JonahLiu/LogeekMax10/art/qr6200.png

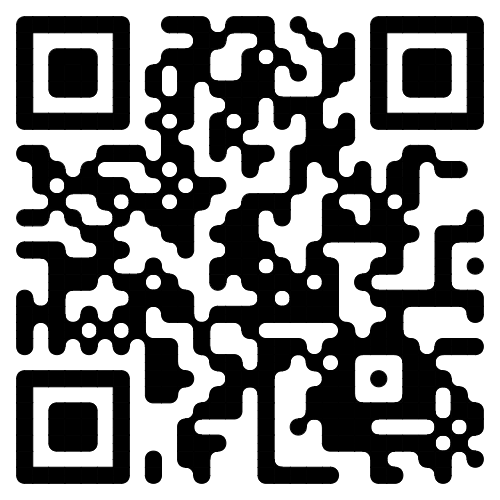
art/qr6200.png
