JonahLiu/LogeekMax10/doc/logeek_mk2.pdf

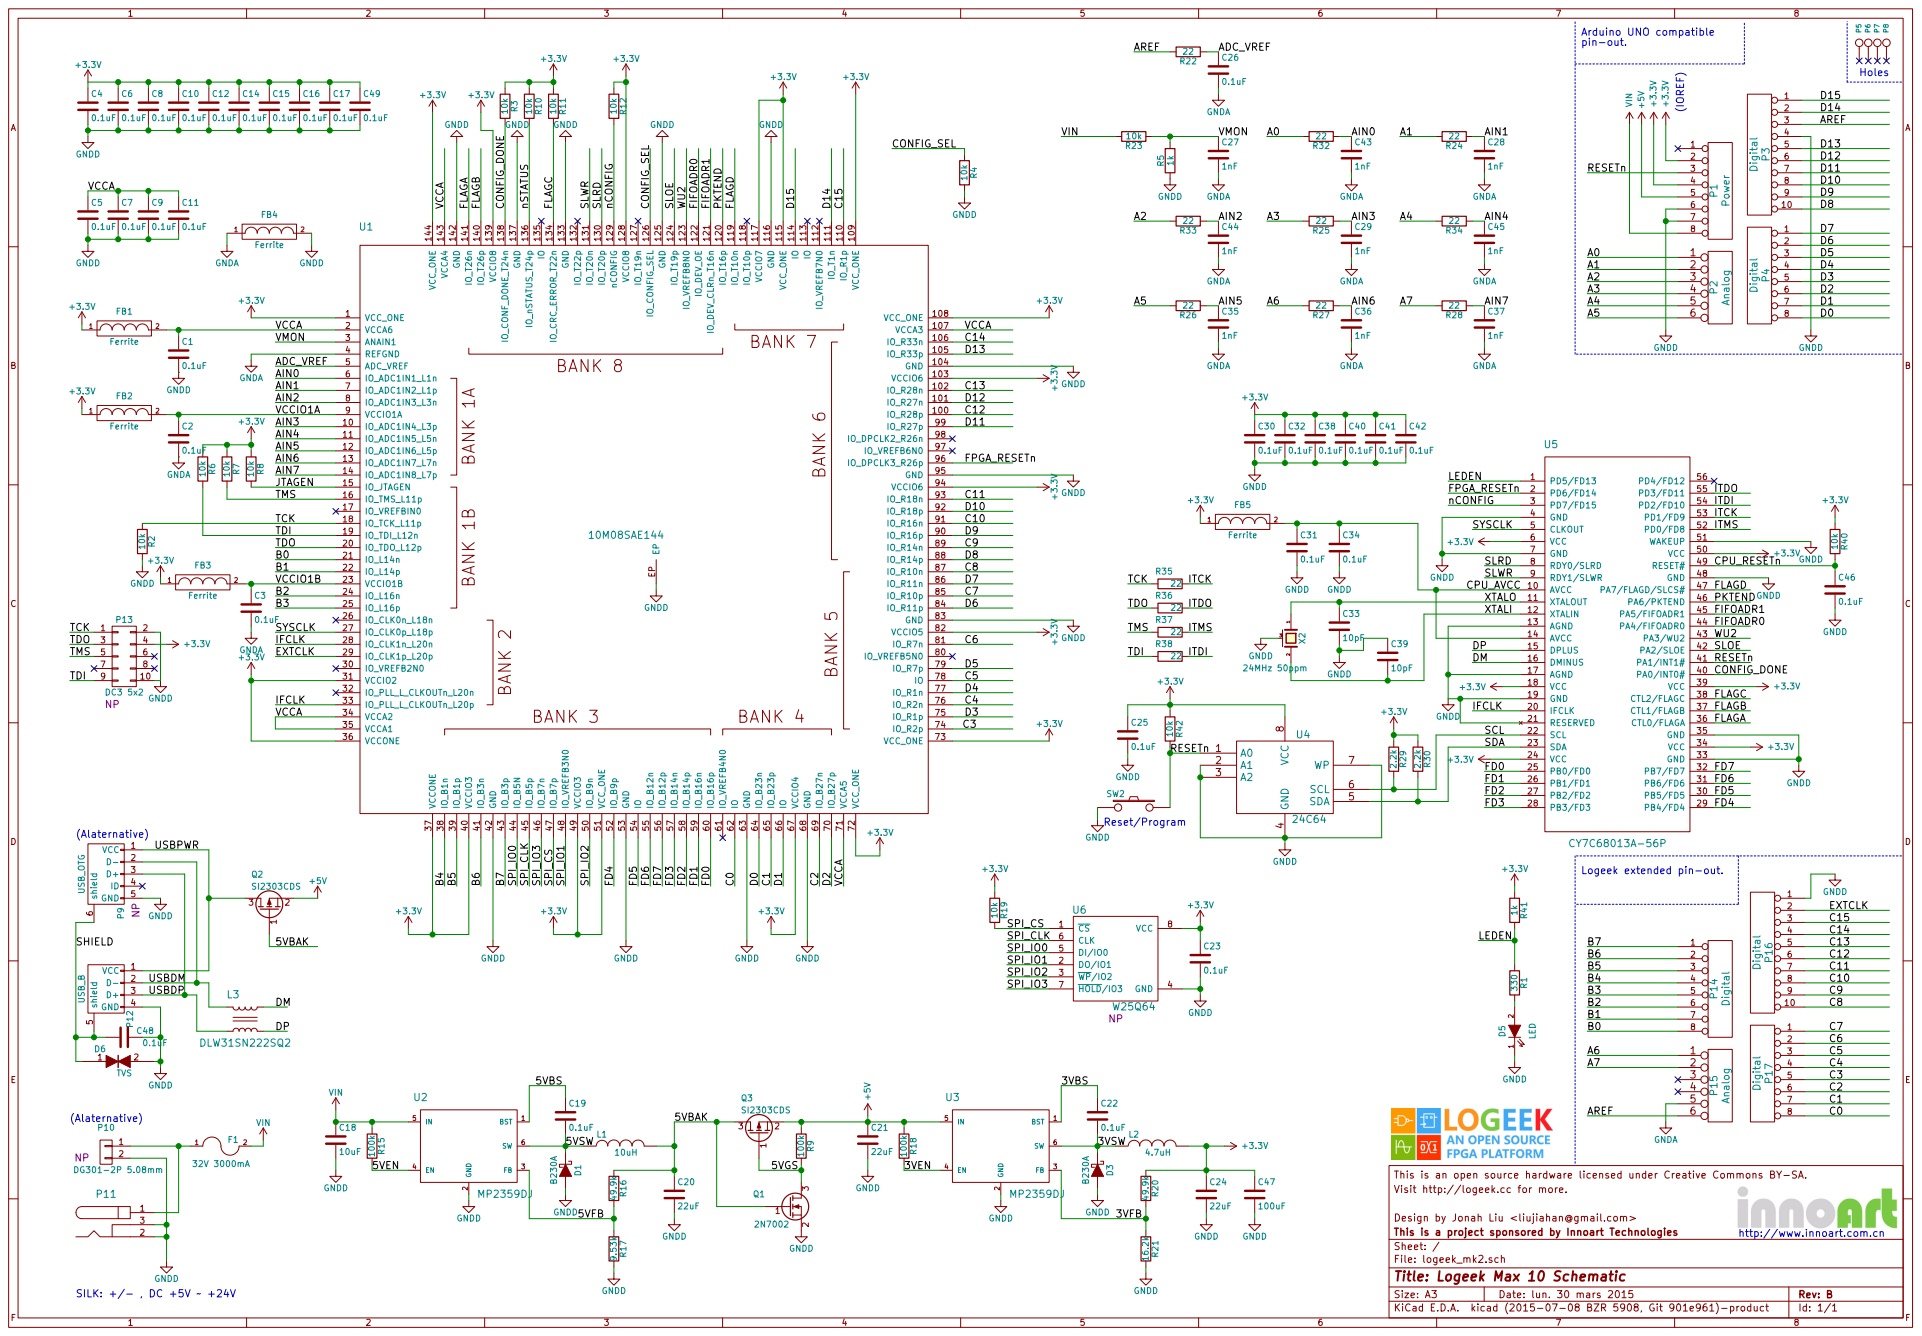
[picture p2: page 1]

This is an open source hardware licensed under Creative Commons BY-SA.
Visit http://logeek.cc for more.

Design by Jonah Liu <liujiahan@gmail.com>
File: logeek_mk2.sch Sheet: / This is a project sponsored by Innoart Technologies

http://www.innoart.com.cn

Id: 1/1 Title: Logeek Max 10 Schematic
