JonahLiu/LogeekMax10/doc/Refdes.pdf

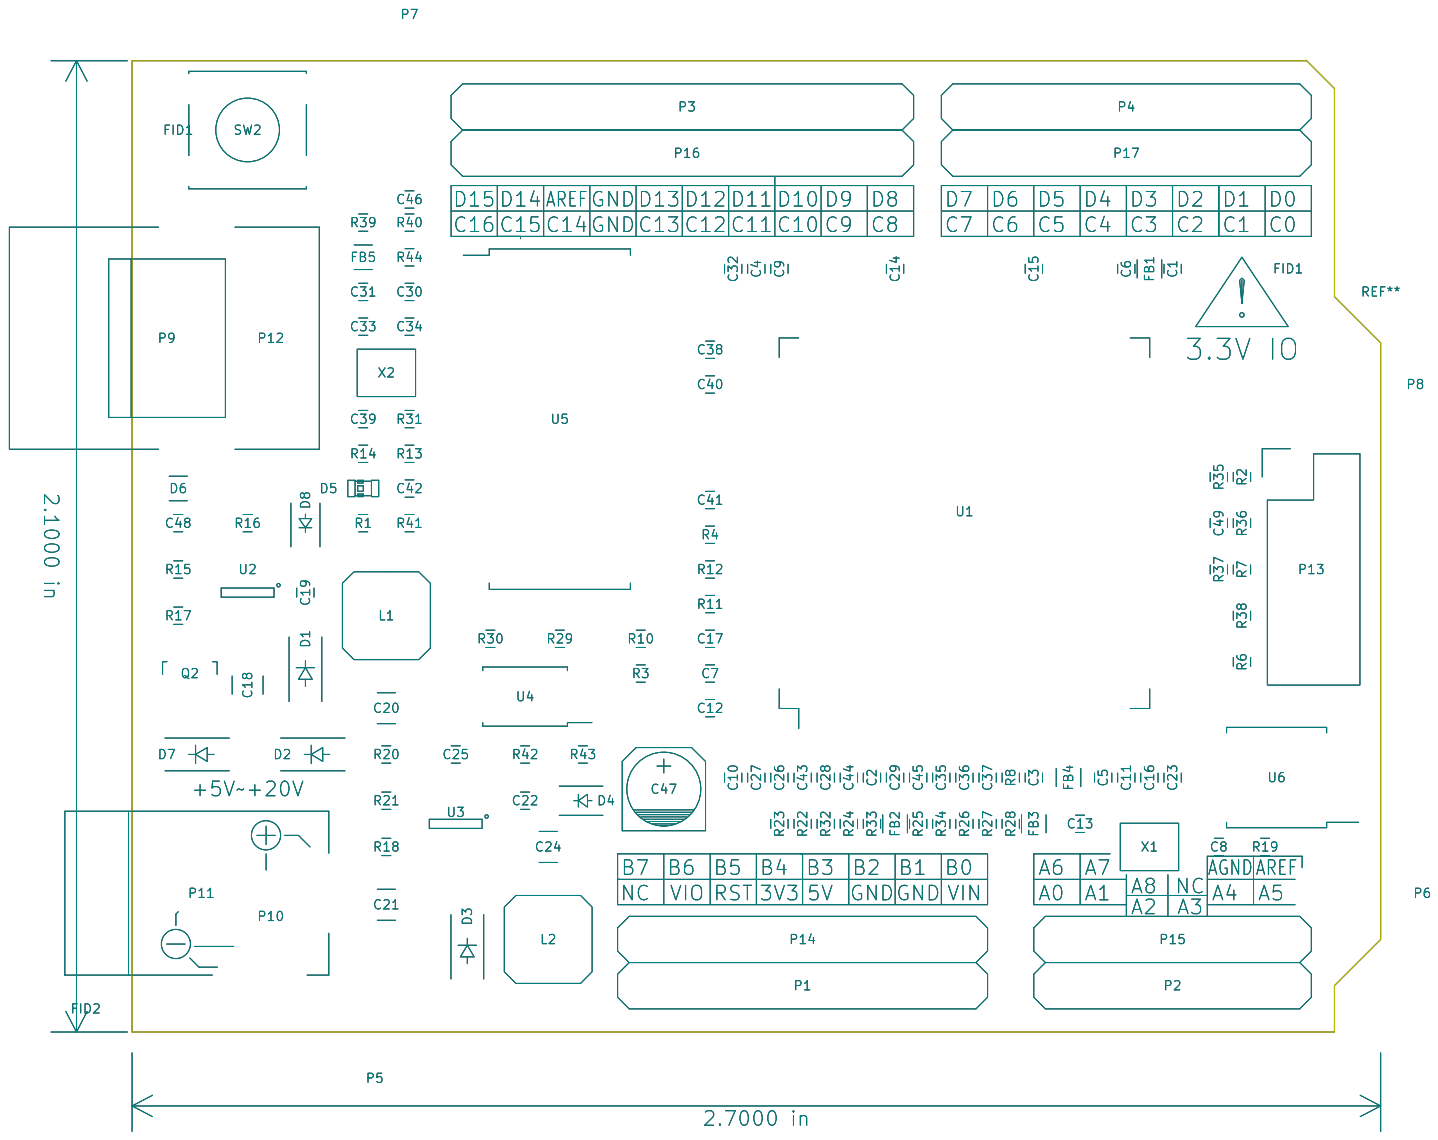
[picture p10: page 1]
