JonahLiu/LogeekMax10/pcb/logeek_mk2.kicad_pcb

## KiCad design pcb/logeek_mk2.kicad_pcb (2016-01-05)

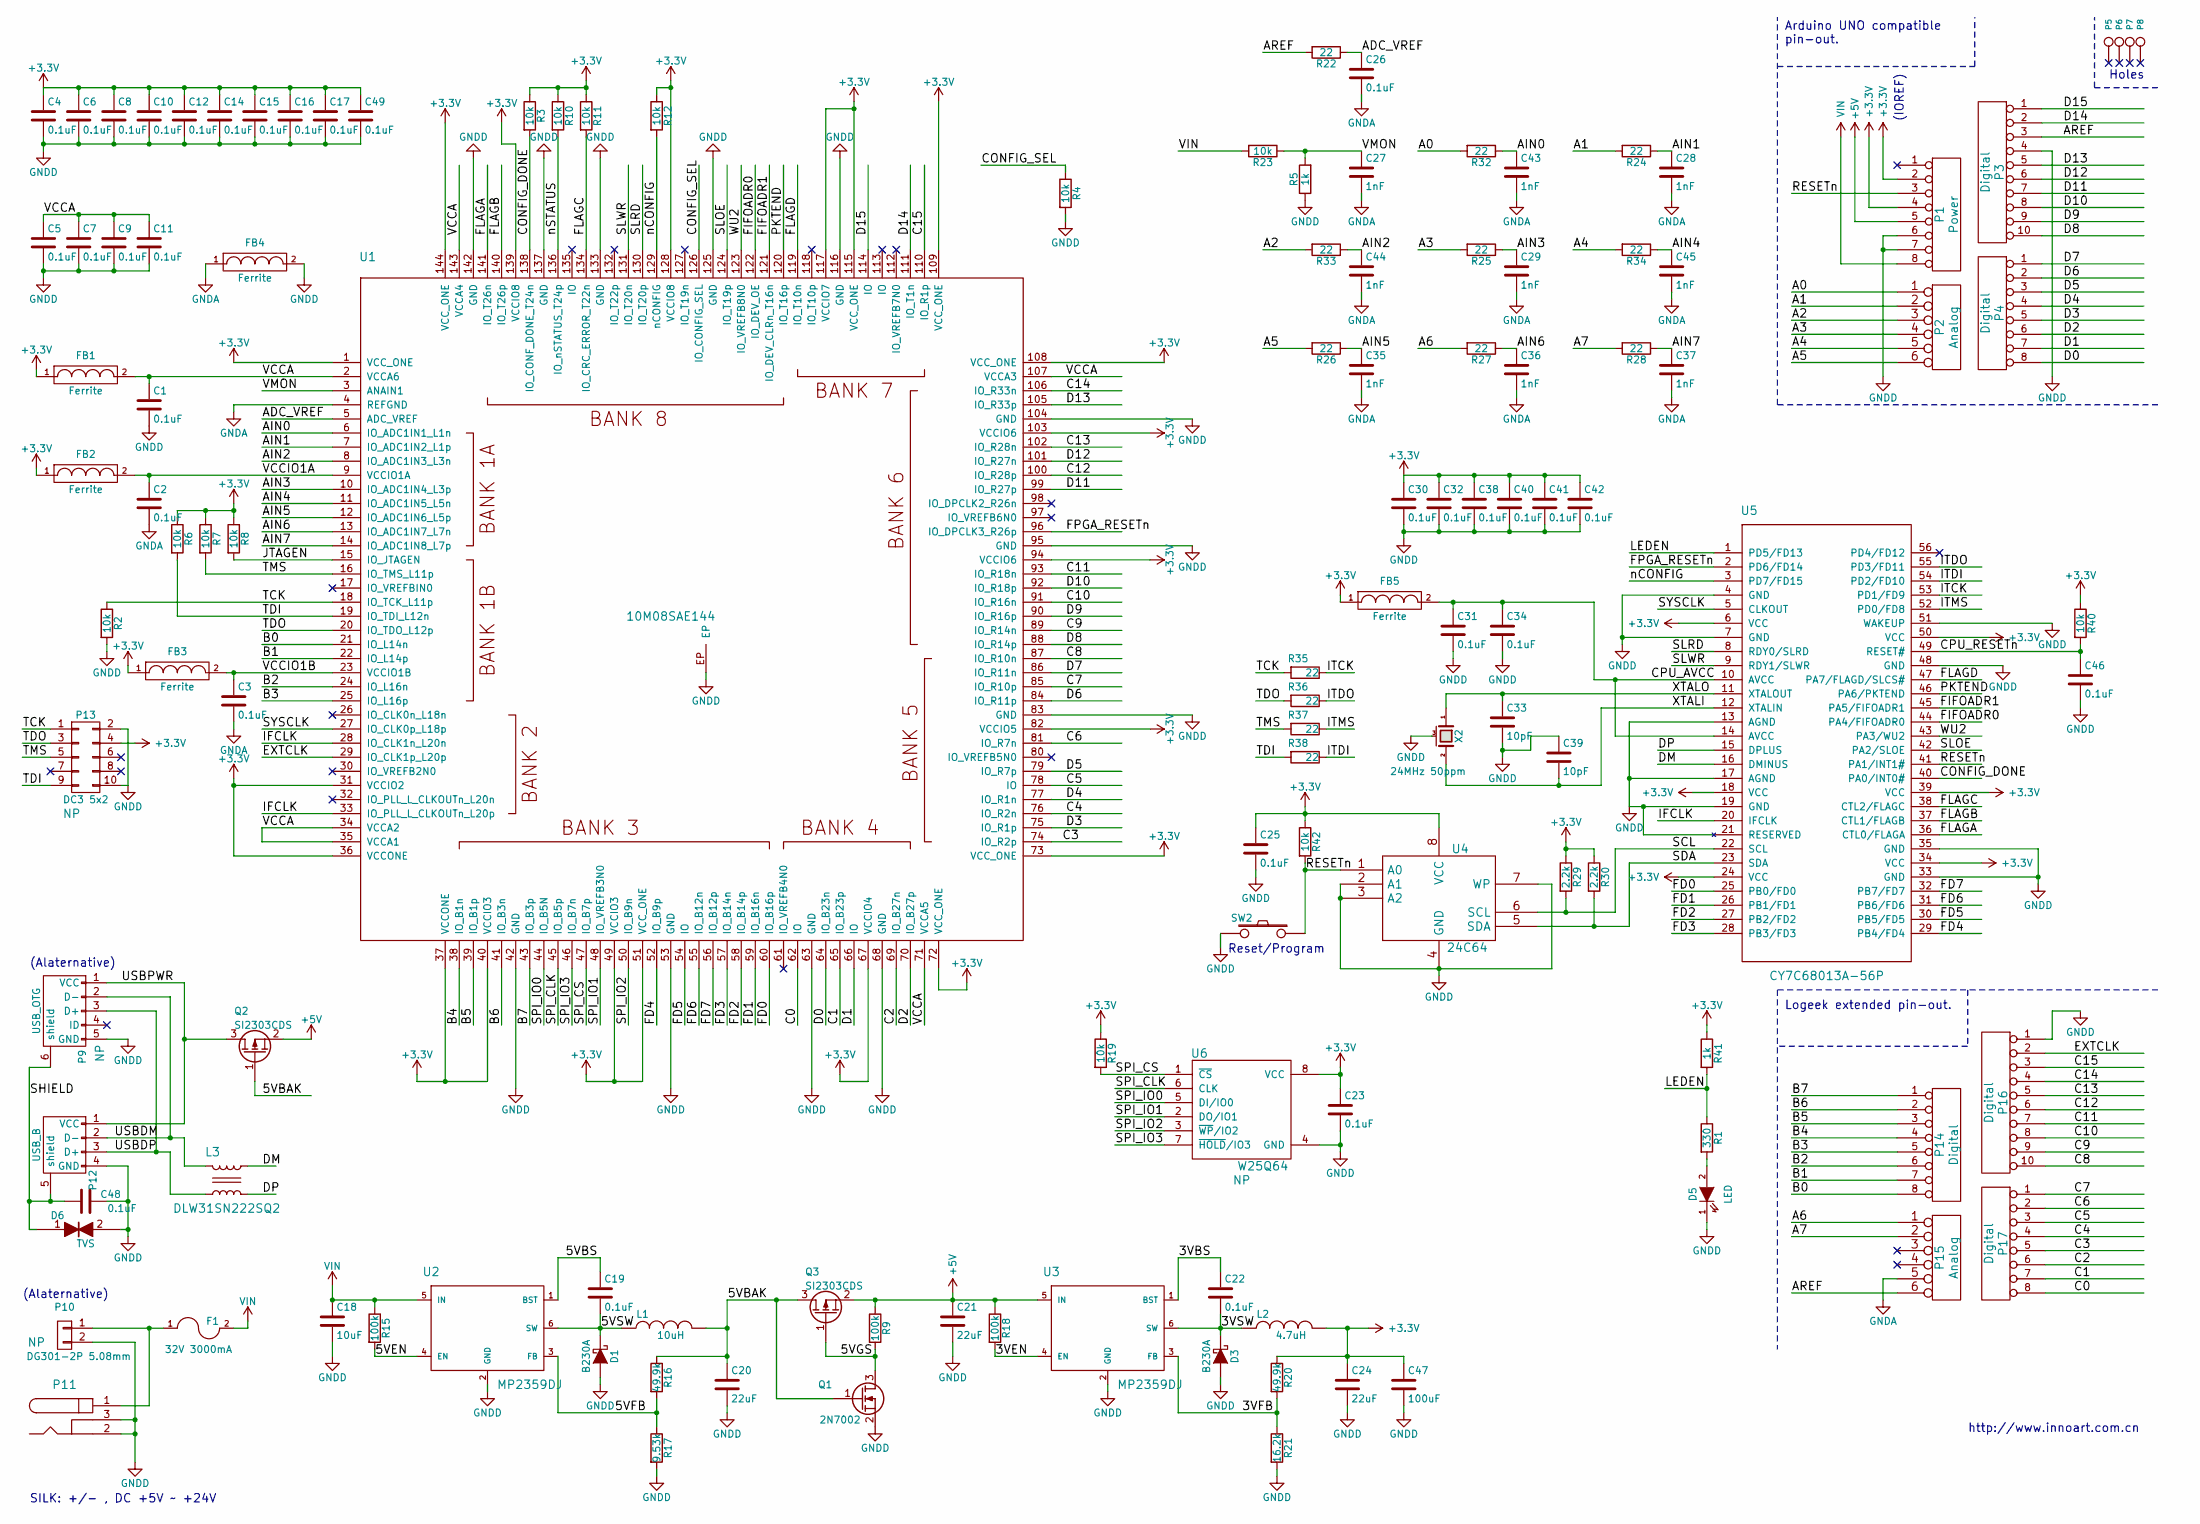
[picture p11: schematic logeek_mk2.sch, Logeek Max 10 Schematic]

Parts:
C1, C2, C3, C4, C5, C6, C7, C8, C9, C10, C11, C12, C14, C15, C16, C17, C19, C22, C23, C25, C26, C30, C31, C32, C34, C38, C40, C41, C42, C46, C48, C49: 0.1uF; C_0402
C18: 10uF; C_1206
C20, C21, C24: 22uF; C_0805
C27, C28, C29, C35, C36, C37, C43, C44, C45: 1nF; C_0402
C33, C39: 10pF; C_0402
C47: 100uF; c_elec_5x5.8
D1, D3: B230A; Diode-SMA_Standard
D5: LED; LED-0603
D6: TVS; R_0402_HandSoldering
F1: 32V 3000mA; Fuse_SMD1206_Wave
FB1, FB2, FB3, FB4, FB5: Ferrite; R_0603
L1: 10uH; Inductor_SM-2020
L2: 4.7uH; Inductor_SM-2020
L3: DLW31SN222SQ2; CommonModeChoke_1206
P1: Power; Socket_Strip_Arduino_1x08
P2, P15: Analog; Socket_Strip_Arduino_1x06
P3, P16: Digital; Socket_Strip_Arduino_1x10
P4, P14, P17: Digital; Socket_Strip_Arduino_1x08
P5, P6, P7, P8: MH; Arduino_1pin
P9: USB_OTG; USB_Micro-B
P10: DG301-2P 5.08mm; DG301_2P_5.08mm_Straight
P11: Barrel Jack; BARREL_JACK
P12: USB_B
P13: DC3 5x2; Pin_Header_Straight_2x05
Q1: 2N7002; SOT-23
Q2, Q3: SI2303CDS; SOT-23
R1: 330; R_0402_HandSoldering
R2, R3, R4, R6, R7, R8, R10, R11, R12, R19, R23, R40, R42: 10k; R_0402_HandSoldering
R5, R41: 1k; R_0402_HandSoldering
R9, R15, R18: 100k; R_0402_HandSoldering
R16, R20: 49.9k; R_0402_HandSoldering
R17: 9.53k; R_0402_HandSoldering
R21: 16.2k; R_0402_HandSoldering
R22, R24, R25, R26, R27, R28, R32, R33, R34, R35, R36, R37, R38: 22; R_0402_HandSoldering
R29, R30: 2.2k; R_0402_HandSoldering
SW2: PB 4P; SW_SPST_PTS645
U1: 10M08SAE144; TQFP-144EP_20x20mm_Pitch0.5mm
U2, U3: MP2359DJ; SOT-23-6
U4: 24C64; TSSOP-8_4.4x3mm_Pitch0.65mm
U5: CY7C68013A-56P; SSOP-56_7.5x18.5mm_Pitch0.635mm
U6: W25Q64; SOIJ-8_5.3x5.3mm_Pitch1.27mm
X2: 24MHz 50ppm; XTAL3225

Connections:
+3V3: C4.1, C6.1, C8.1, C10.1, C12.1, C14.1, C15.1, C16.1, C17.1, C23.1, C24.1, C25.1, C30.1, C32.1, C38.1, C40.1, C41.1, C42.1, C47.1, C49.1, FB1.1, FB2.1, FB3.1, FB5.1, L2.2, P1.2, P1.4, P13.4, R3.1, R6.1, R7.1, R8.1, R10.1, R11.1, R12.1, R19.1, R20.1, R29.1, R30.1, R40.1, R41.1, R42.1, U1.1 (VCC_ONE), U1.31 (VCCIO2), U1.36 (VCCONE), U1.37 (VCCONE), U1.40 (VCCIO3), U1.49 (VCCIO3), U1.51 (VCC_ONE), U1.67 (VCCIO4), U1.72 (VCC_ONE), U1.73 (VCC_ONE), U1.82 (VCCIO5), U1.94 (VCCIO6), U1.103 (VCCIO6), U1.108 (VCC_ONE), U1.109 (VCC_ONE), U1.115 (VCC_ONE), U1.117 (VCCIO7), U1.128 (VCCIO8), U1.139 (VCCIO8), U1.144 (VCC_ONE), U4.8 (VCC), U5.6 (VCC), U5.18 (VCC), U5.24 (VCC), U5.34 (VCC), U5.39 (VCC), U5.50 (VCC), U6.8 (VCC)
+5V: C21.1, P1.5, Q2.2 (S), Q3.2 (S), R9.1, R18.1, U3.5 (IN)
/3VBS: C22.1, U3.1 (BST)
/3VEN: R18.2, U3.4 (EN)
/3VFB: R20.2, R21.1, U3.3 (FB)
/3VSW: C22.2, D3.1 (K), L2.1, U3.6 (SW)
/5VBAK: C20.1, L1.2, Q1.1 (G), Q2.1 (G), Q3.3 (D), R16.1
/5VBS: C19.1, U2.1 (BST)
/5VEN: R15.2, U2.4 (EN)
/5VFB: R16.2, R17.1, U2.3 (FB)
/5VGS: Q1.3 (D), Q3.1 (G), R9.2
/5VSW: C19.2, D1.1 (K), L1.1, U2.6 (SW)
/A0: P2.1, R32.2
/A1: P2.2, R24.2
/A2: P2.3, R33.2
/A3: P2.4, R25.2
/A4: P2.5, R34.2
/A5: P2.6, R26.2
/A6: P15.1, R27.2
/A7: P15.2, R28.2
/ADC_VREF: C26.1, R22.1, U1.5 (ADC_VREF)
/AIN0: C43.1, R32.1, U1.6 (IO_ADC1IN1_L1n)
/AIN1: C28.1, R24.1, U1.7 (IO_ADC1IN2_L1p)
/AIN2: C44.1, R33.1, U1.8 (IO_ADC1IN3_L3n)
/AIN3: C29.1, R25.1, U1.10 (IO_ADC1IN4_L3p)
/AIN4: C45.1, R34.1, U1.11 (IO_ADC1IN5_L5n)
/AIN5: C35.1, R26.1, U1.12 (IO_ADC1IN6_L5p)
/AIN6: C36.1, R27.1, U1.13 (IO_ADC1IN7_L7n)
/AIN7: C37.1, R28.1, U1.14 (IO_ADC1IN8_L7p)
/AREF: P3.3, P15.6, R22.2
/B0: P14.8, U1.21 (IO_L14n)
/B1: P14.7, U1.22 (IO_L14p)
/B2: P14.6, U1.24 (IO_L16n)
/B3: P14.5, U1.25 (IO_L16p)
/B4: P14.4, U1.38 (IO_B1n)
/B5: P14.3, U1.39 (IO_B1p)
/B6: P14.2, U1.41 (IO_B3n)
/B7: P14.1, U1.43 (IO_B3p)
/C0: P17.8, U1.62 (IO)
/C1: P17.7, U1.65 (IO_B23p)
/C2: P17.6, U1.69 (IO_B27n)
/C3: P17.5, U1.74 (IO_R2p)
/C4: P17.4, U1.76 (IO_R2n)
/C5: P17.3, U1.78 (IO)
/C6: P17.2, U1.81 (IO_R7n)
/C7: P17.1, U1.85 (IO_R10p)
/C8: P16.10, U1.87 (IO_R10n)
/C9: P16.9, U1.89 (IO_R14n)
/C10: P16.8, U1.91 (IO_R16n)
/C11: P16.7, U1.93 (IO_R18n)
/C12: P16.6, U1.100 (IO_R28p)
/C13: P16.5, U1.102 (IO_R28n)
/C14: P16.4, U1.106 (IO_R33n)
/C15: P16.3, U1.110 (IO_R1p)
/CONFIG_DONE: R3.2, U1.138 (IO_CONF_DONE_T24n), U5.40 (PA0/INT0#)
/CONFIG_SEL: R4.1, U1.126 (IO_CONFIG_SEL)
/CPU_AVCC: C31.1, C34.1, FB5.2, U5.10 (AVCC), U5.14 (AVCC)
/CPU_RESETn: C46.1, R40.2, U5.49 (RESET#)
/D0: P4.8, U1.64 (IO_B23n)
/D1: P4.7, U1.66 (IO)
/D2: P4.6, U1.70 (IO_B27p)
/D3: P4.5, U1.75 (IO_R1p)
/D4: P4.4, U1.77 (IO_R1n)
/D5: P4.3, U1.79 (IO_R7p)
/D6: P4.2, U1.84 (IO_R11p)
/D7: P4.1, U1.86 (IO_R11n)
/D8: P3.10, U1.88 (IO_R14p)
/D9: P3.9, U1.90 (IO_R16p)
/D10: P3.8, U1.92 (IO_R18p)
/D11: P3.7, U1.99 (IO_R27p)
/D12: P3.6, U1.101 (IO_R27n)
/D13: P3.5, U1.105 (IO_R33p)
/D14: P3.2, U1.111 (IO_T1n)
/D15: P3.1, U1.114 (IO)
/DM: L3.2, U5.16 (DMINUS)
/DP: L3.3, U5.15 (DPLUS)
/EXTCLK: P16.2, U1.29 (IO_CLK1p_L20p)
/FD0: U1.60 (IO_B16p), U5.25 (PB0/FD0)
/FD1: U1.59 (IO_B16n), U5.26 (PB1/FD1)
/FD2: U1.58 (IO_B14p), U5.27 (PB2/FD2)
/FD3: U1.57 (IO_B14n), U5.28 (PB3/FD3)
/FD4: U1.52 (IO_B9p), U5.29 (PB4/FD4)
/FD5: U1.54 (IO), U5.30 (PB5/FD5)
/FD6: U1.55 (IO_B12n), U5.31 (PB6/FD6)
/FD7: U1.56 (IO_B12p), U5.32 (PB7/FD7)
/FIFOADR0: U1.122 (IO_DEV_OE), U5.44 (PA4/FIFOADR0)
/FIFOADR1: U1.121 (IO_DEV_CLRn_T16n), U5.45 (PA5/FIFOADR1)
/FLAGA: U1.141 (IO_T26n), U5.36 (CTL0/FLAGA)
/FLAGB: U1.140 (IO_T26p), U5.37 (CTL1/FLAGB)
/FLAGC: R11.2, U1.134 (IO_CRC_ERROR_T22n), U5.38 (CTL2/FLAGC)
/FLAGD: U1.119 (IO_T10n), U5.47 (PA7/FLAGD/SLCS#)
/FPGA_RESETn: U1.96 (IO_DPCLK3_R26p), U5.2 (PD6/FD14)
/IFCLK: U1.28 (IO_CLK1n_L20n), U1.33 (IO_PLL_L_CLKOUTn_L20p), U5.20 (IFCLK)
/ITCK: R35.1, U5.53 (PD1/FD9)
/ITDI: R38.1, U5.54 (PD2/FD10)
/ITDO: R36.1, U5.55 (PD3/FD11)
/ITMS: R37.1, U5.52 (PD0/FD8)
/JTAGEN: R8.2, U1.15 (IO_JTAGEN)
/LEDEN: R1.1, R41.2, U5.1 (PD5/FD13)
/PKTEND: U1.120 (IO_T16p), U5.46 (PA6/PKTEND)
/RESETn: P1.3, R42.2, SW2.1, U4.1 (A0), U5.41 (PA1/INT1#)
/SCL: R29.2, U4.6 (SCL), U5.22 (SCL)
/SDA: R30.2, U4.5 (SDA), U5.23 (SDA)
/SHIELD: C48.2, D6.1, P9.6 (shield), P12.5 (shield)
/SLOE: U1.124 (IO_T19p), U5.42 (PA2/SLOE)
/SLRD: U1.130 (IO_T20p), U5.8 (RDY0/SLRD)
/SLWR: U1.131 (IO_T20n), U5.9 (RDY1/SLWR)
/SPI_CLK: U1.45 (IO_B5p), U6.6 (CLK)
/SPI_CS: R19.2, U1.47 (IO_B7p), U6.1 (~CS)
/SPI_IO0: U1.44 (IO_B5N), U6.5 (DI/IO0)
/SPI_IO1: U1.48 (IO_VREFB3N0), U6.2 (DO/IO1)
/SPI_IO2: U1.50 (IO_B9n), U6.3 (~WP~/IO2)
/SPI_IO3: U1.46 (IO_B7n), U6.7 (~HOLD~/IO3)
/SYSCLK: U1.27 (IO_CLK0p_L18p), U5.5 (CLKOUT)
/TCK: P13.1, R2.1, R35.2, U1.18 (IO_TCK_L11p)
/TDI: P13.9, R6.2, R38.2, U1.19 (IO_TDI_L12n)
/TDO: P13.3, R36.2, U1.20 (IO_TDO_L12p)
/TMS: P13.5, R7.2, R37.2, U1.16 (IO_TMS_L11p)
/USBDM: L3.1, P9.2 (D-), P12.2 (D-)
/USBDP: L3.4, P9.3 (D+), P12.3 (D+)
/USBPWR: P9.1 (VCC), P12.1 (VCC), Q2.3 (D)
/VCCA: C1.1, C5.1, C7.1, C9.1, C11.1, FB1.2, U1.2 (VCCA6), U1.34 (VCCA2), U1.35 (VCCA1), U1.71 (VCCA5), U1.107 (VCCA3), U1.143 (VCCA4)
/VCCIO1A: C2.1, FB2.2, U1.9 (VCCIO1A)
/VCCIO1B: C3.1, FB3.2, U1.23 (VCCIO1B)
/VMON: C27.1, R5.2, R23.1, U1.3 (ANAIN1)
/WU2: U1.123 (IO_VREFB8N0), U5.43 (PA3/WU2)
/XTALI: C39.2, U5.12 (XTALIN), X2.2
/XTALO: C33.1, U5.11 (XTALOUT), X2.1
/nCONFIG: R12.2, U1.129 (nCONFIG), U5.3 (PD7/FD15)
/nSTATUS: R10.2, U1.136 (IO_nSTATUS_T24p)
GNDA: C2.2, C3.2, C26.2, C27.2, C28.2, C29.2, C35.2, C36.2, C37.2, C43.2, C44.2, C45.2, FB4.1, P15.5, U1.4 (REFGND)
GNDD: C1.2, C4.2, C5.2, C6.2, C7.2, C8.2, C9.2, C10.2, C11.2, C12.2, C14.2, C15.2, C16.2, C17.2, C18.2, C20.2, C21.2, C23.2, C24.2, C25.2, C30.2, C31.2, C32.2, C33.2, C34.2, C38.2, C39.1, C40.2, C41.2, C42.2, C46.2, C47.2, C48.1, C49.2, D1.2 (A), D3.2 (A), D5.1 (K), D6.2, FB4.2, P1.6, P1.7, P3.4, P9.5 (GND), P10.2, P11.2, P11.3, P12.4 (GND), P13.2, P13.10, P16.1, Q1.2 (S), R2.2, R4.2, R5.1, R17.2, R21.2, SW2.2, U1.42 (GND), U1.53 (GND), U1.63 (GND), U1.68 (GND), U1.83 (GND), U1.95 (GND), U1.104 (GND), U1.116 (GND), U1.125 (GND), U1.133 (GND), U1.137 (GND), U1.142 (GND), U1.EP, U2.2 (GND), U3.2 (GND), U4.2 (A1), U4.3 (A2), U4.4 (GND), U4.7 (WP), U5.4 (GND), U5.7 (GND), U5.13 (AGND), U5.17 (AGND), U5.19 (GND), U5.21 (RESERVED), U5.33 (GND), U5.35 (GND), U5.48 (GND), U5.51 (WAKEUP), U6.4 (GND), X2.3 (case)
unnamed: D5.2 (A), R1.2
unnamed: F1.1, P10.1, P11.1
VIN: C18.1, F1.2, P1.8, R15.1, R23.2, U2.5 (IN)

Notes on the sheet:
Holes
Arduino UNO compatible pin-out.
(Alaternative)
SILK: +/- , DC +5V ~~ +24V
(IOREF)
Logeek extended pin-out.
http://www.innoart.com.cn
Reset/Program

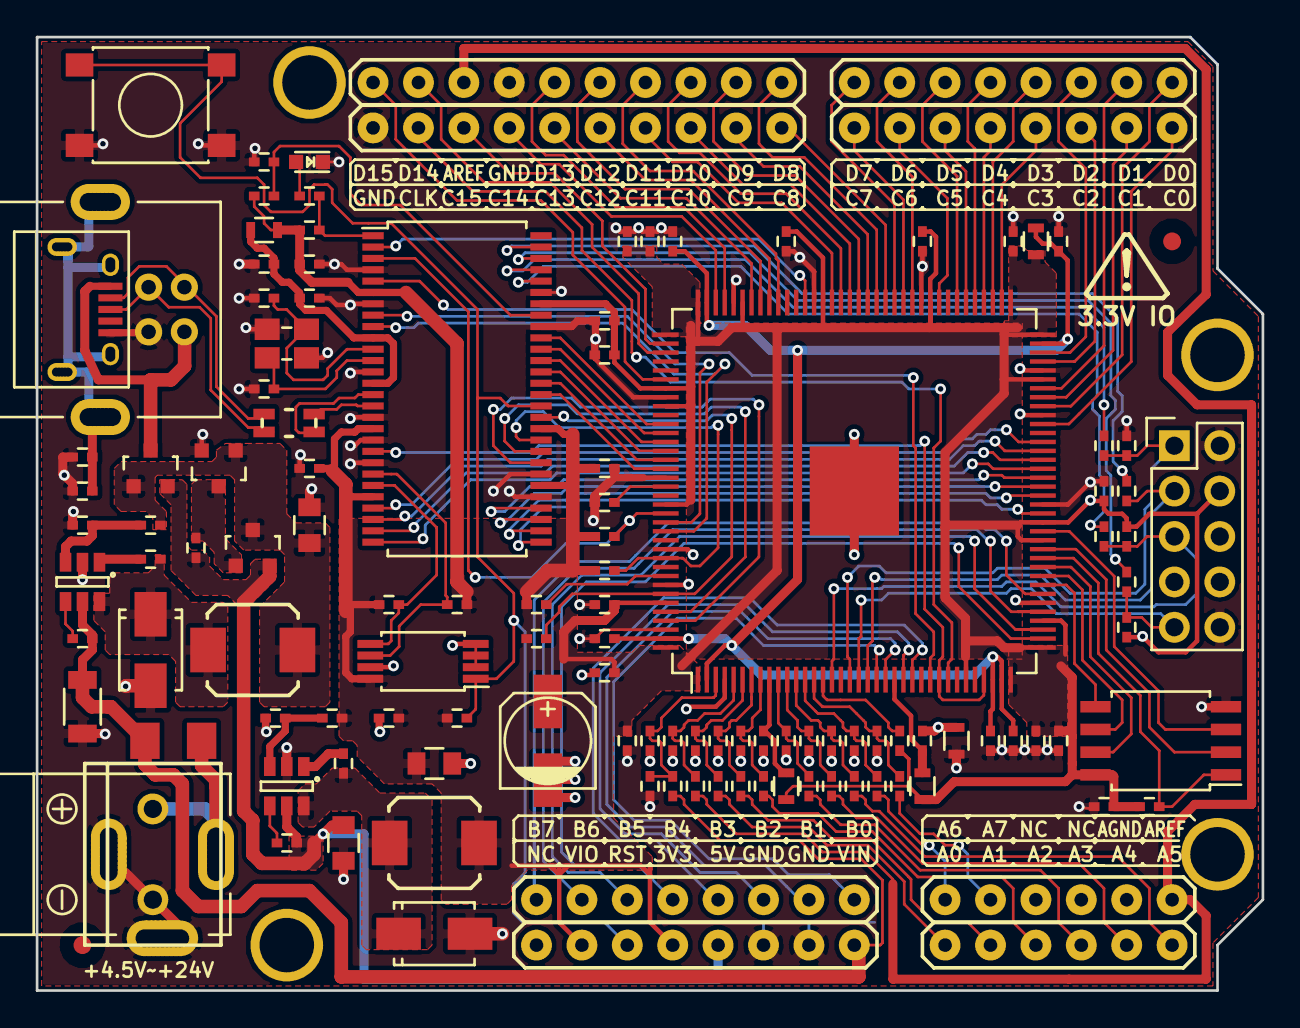
[picture p12: board logeek_mk2.kicad_pcb from above]

Board: 2 copper layers, 68.6 x 53.3 mm, 129 parts (0 on the bottom side), 135 nets.

Other parts of the board:
FID1, FID2: F; Fiducial_1mm_Dia_2.54mm_Outer_CopperTop
