JonahLiu/LogeekMax10/(commit log)

2015-11-05 Imported source files.
    [logeek_mk2-B_Cu.gbl, logeek_mk2-B_Mask.gbs, logeek_mk2-B_Paste.gbp, logeek_mk2-B_SilkS.gbo, logeek_mk2-Edge_Cuts.gm1, logeek_mk2-F_Cu.gtl, logeek_mk2-F_Mask.gts, logeek_mk2-F_Paste.gtp]
2015-11-05 Part value update.
    [logeek_mk2.kicad_pcb, logeek_mk2.sch]
2015-11-10 Corrected FPGA footprint. Delete extra oscillator. Update silkscreen.
    [logeek_mk2.kicad_pcb, logeek_mk2.sch]
2015-12-06 Updated socket footprints.
    [logeek_mk2.kicad_pcb, logeek_mk2.sch]
2015-12-06 Footprints update.
    [logeek_mk2.kicad_pcb, logeek_mk2.sch]
2015-12-06 Add EXTCLK.
    [logeek_mk2.kicad_pcb, logeek_mk2.sch]
2015-12-06 Analog pin-mapping changed to support VIN monitoring.
    [logeek_mk2.kicad_pcb, logeek_mk2.sch]
2015-12-06 FPGA footprint center pad updated.
    [logeek_mk2.kicad_pcb, logeek_mk2.sch]
2015-12-06 Silkscreen art updated.
    [logeek_mk2-B_Cu.gbl, logeek_mk2-B_Mask.gbs, logeek_mk2-B_Paste.gbp, logeek_mk2-B_SilkS.gbo, logeek_mk2-Edge_Cuts.gm1, logeek_mk2-F_Cu.gtl, logeek_mk2-F_Mask.gts, logeek_mk2-F_Paste.gtp]
2015-12-06 Fine-tune copper and silkscreen. Add a fuse on USB power input.
    [logeek_mk2.kicad_pcb, logeek_mk2.sch]
2015-12-07 Power input socket changed to 5.08mm terminal.
    [logeek_mk2-B_Cu.gbl, logeek_mk2-B_Mask.gbs, logeek_mk2-B_Paste.gbp, logeek_mk2-B_SilkS.gbo, logeek_mk2-Edge_Cuts.gm1, logeek_mk2-F_Cu.gtl, logeek_mk2-F_Mask.gts, logeek_mk2-F_Paste.gtp]
2015-12-07 C14,C15,CLK and GND pins changed.
    [logeek_mk2.kicad_pcb, logeek_mk2.sch]
2015-12-07 Fine-tuned silk art. Gerber generated.
    [logeek_mk2-B_Cu.gbl, logeek_mk2-B_Mask.gbs, logeek_mk2-B_Paste.gbp, logeek_mk2-B_SilkS.gbo, logeek_mk2-Edge_Cuts.gm1, logeek_mk2-F_Cu.gtl, logeek_mk2-F_Mask.gts, logeek_mk2-F_Paste.gtp]
2015-12-20 Power supplies redesigned.
    [logeek_mk2-B_Cu.gbl, logeek_mk2-B_Mask.gbs, logeek_mk2-B_Paste.gbp, logeek_mk2-B_SilkS.gbo, logeek_mk2-Edge_Cuts.gm1, logeek_mk2-F_Cu.gtl, logeek_mk2-F_Mask.gts, logeek_mk2-F_Paste.gtp]
2015-12-22 Updates for better 3D looking.
    [logeek_mk2.kicad_pcb]
2015-12-23 Minor footprint change.
    [logeek_mk2.sch]
2015-12-23 Power switching circuit updated for safety issue.
    [logeek_mk2.kicad_pcb, logeek_mk2.sch]
2015-12-23 Assigned colored 3d model
    [logeek_mk2.kicad_pcb]
2015-12-24 Add a fuse to protest against VIN short-circuit.
    [logeek_mk2.kicad_pcb, logeek_mk2.sch]
2015-12-26 Updated 3D shapes
    [logeek_mk2.kicad_pcb]
2015-12-28 Updated silk art.
    [logeek_mk2.kicad_pcb]
2015-12-28 Final revise before fabrication of Rev.B
    [logeek_mk2-B_Cu.gbl, logeek_mk2-B_Mask.gbs, logeek_mk2-B_Paste.gbp, logeek_mk2-B_SilkS.gbo, logeek_mk2-Edge_Cuts.gm1, logeek_mk2-F_Cu.gtl, logeek_mk2-F_Mask.gts, logeek_mk2-F_Paste.gtp]
2016-01-05 Annotation update.
    [logeek_mk2.kicad_pcb, logeek_mk2.sch]
